Electronics-world9/Wallace-Tree-Multiplier-using-bypass-adder/images/stage1.png

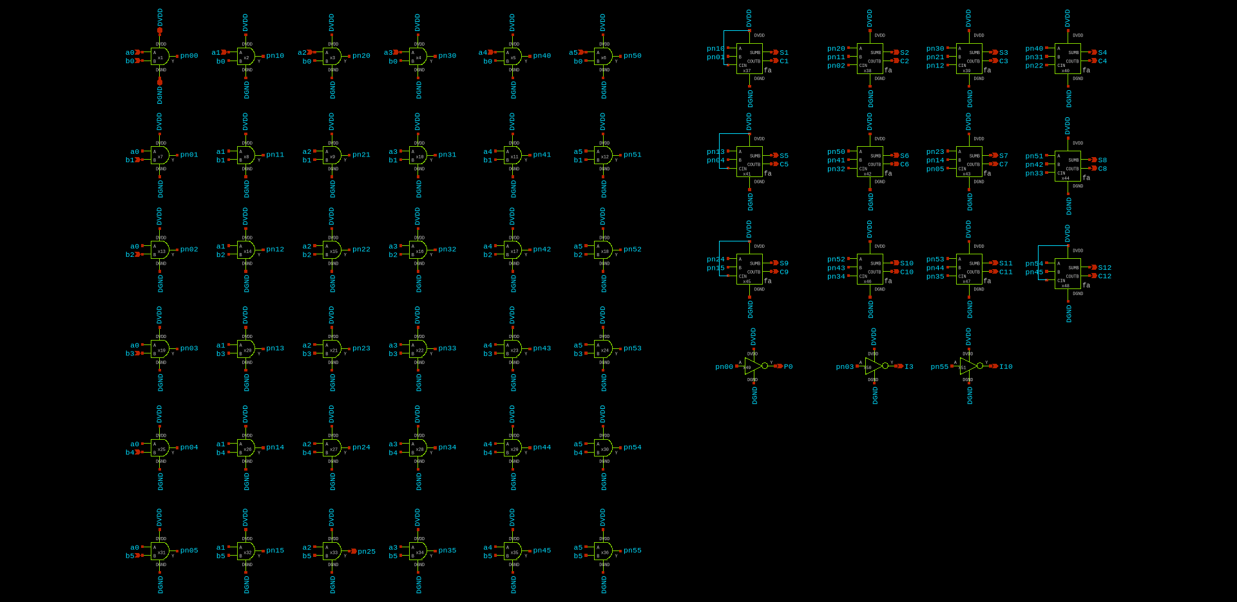
images/stage1.png
