Electronics-world9/Wallace-Tree-Multiplier-using-bypass-adder/images/stage2.png

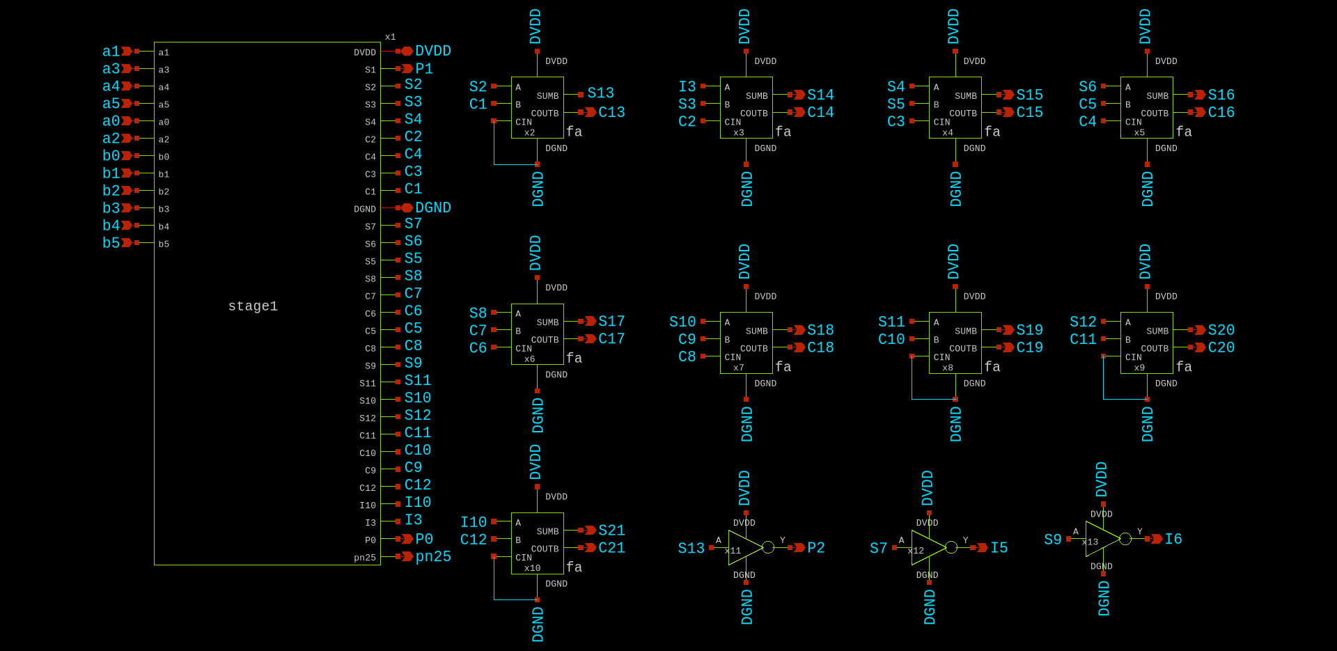
images/stage2.png
