Electronics-world9/Wallace-Tree-Multiplier-using-bypass-adder/images/stage3.png

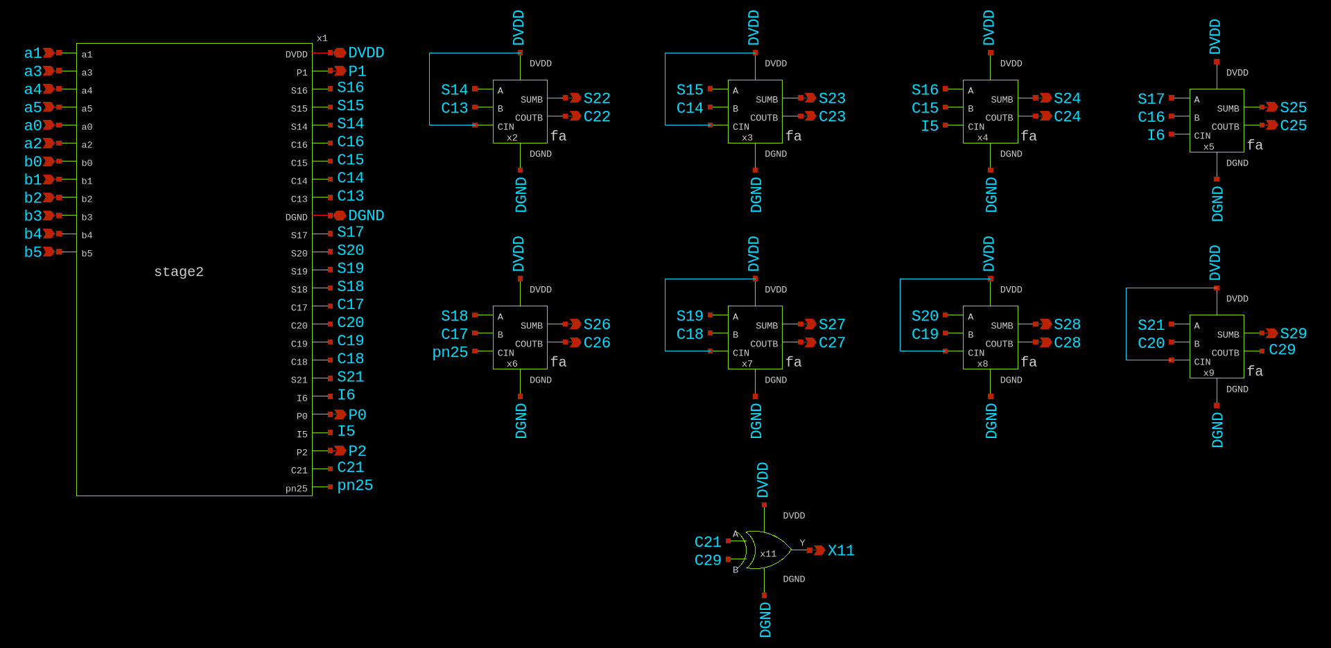
images/stage3.png
