Electronics-world9/Wallace-Tree-Multiplier-using-bypass-adder/images/post_layout_testbench.png

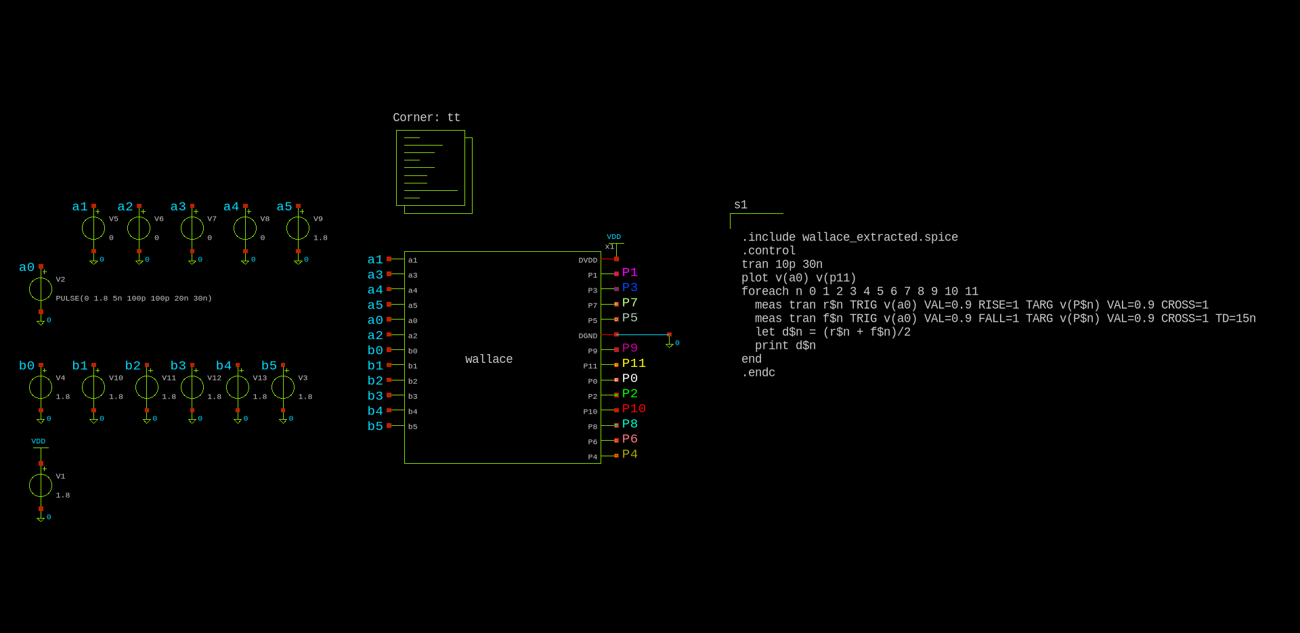
images/post_layout_testbench.png
