Electronics-world9/Wallace-Tree-Multiplier-using-bypass-adder/images/pre_layout_testbench.png

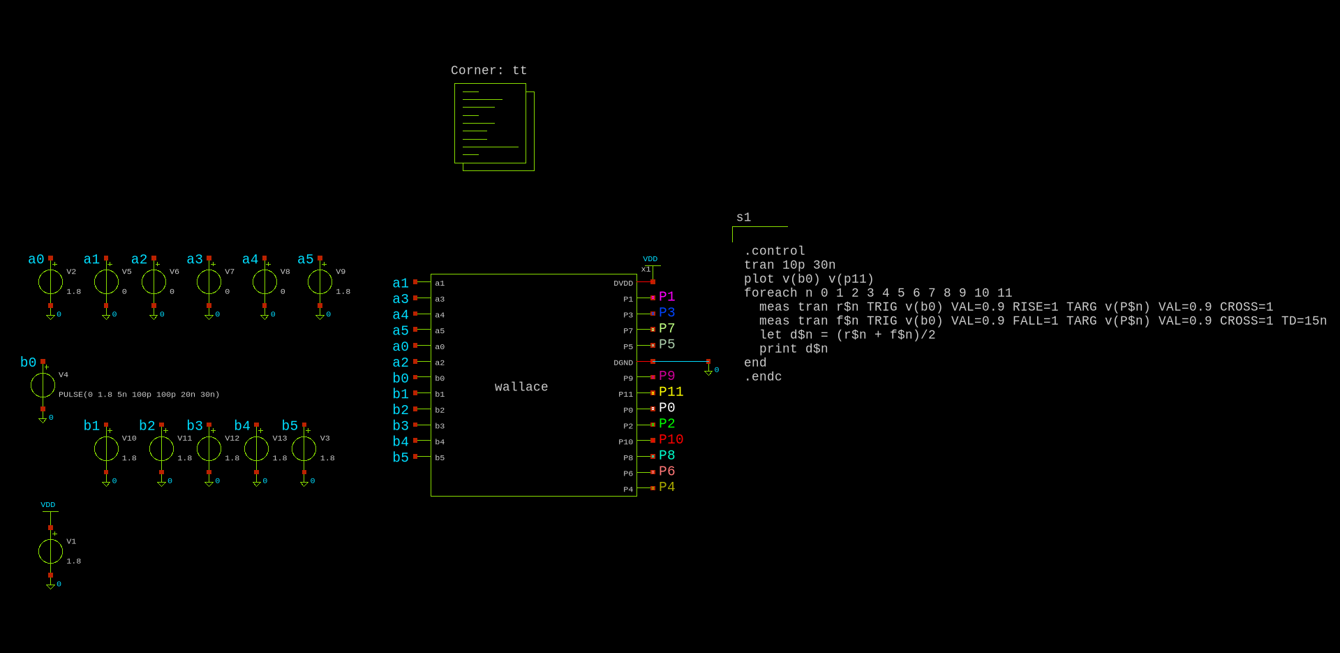
images/pre_layout_testbench.png
