Electronics-world9/Wallace-Tree-Multiplier-using-bypass-adder/images/results/drc_no_errors.png

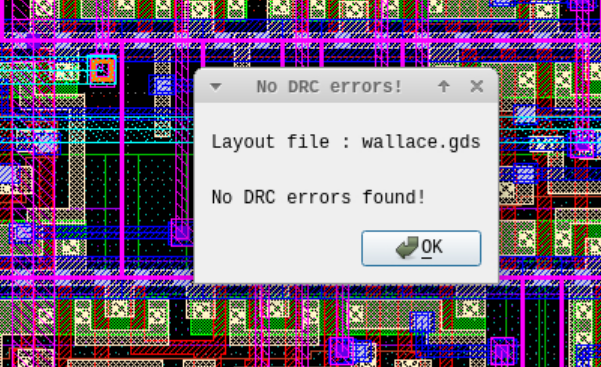
images/results/drc_no_errors.png
