Electronics-world9/Wallace-Tree-Multiplier-using-bypass-adder/images/results/lvs_match.png

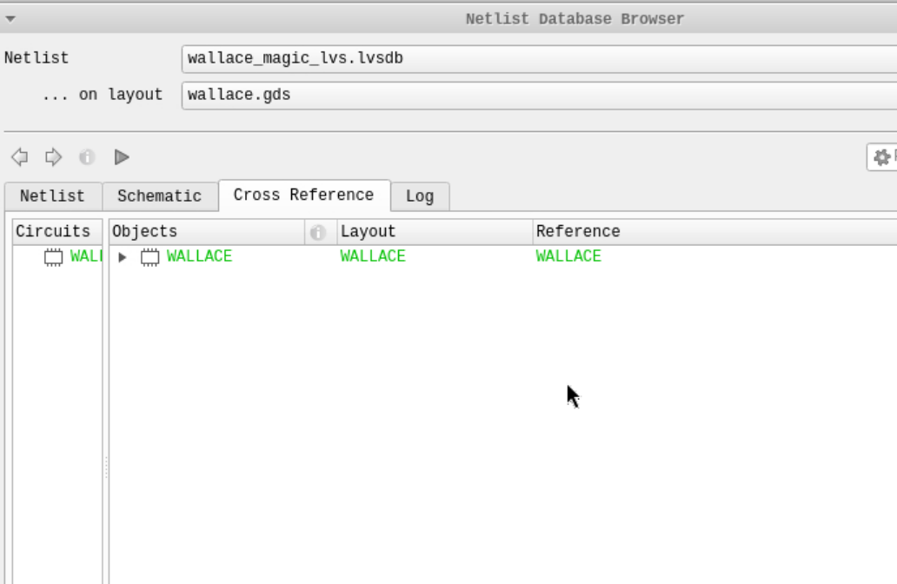
images/results/lvs_match.png
