Electronics-world9/Wallace-Tree-Multiplier-using-bypass-adder/images/results/post_layout_delay_vector3.png

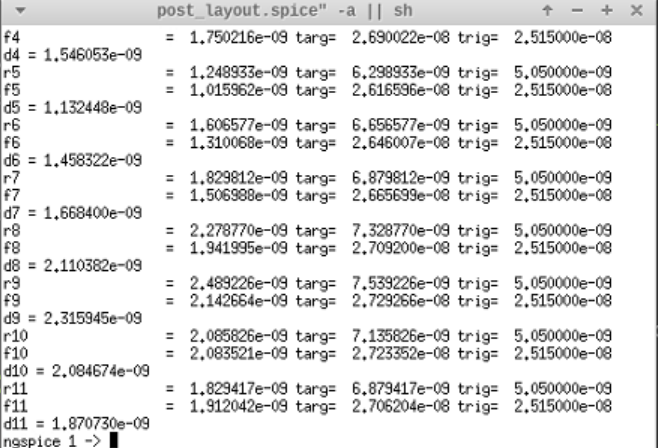
images/results/post_layout_delay_vector3.png
