Electronics-world9/Wallace-Tree-Multiplier-using-bypass-adder/images/results/post_layout_waveform.png

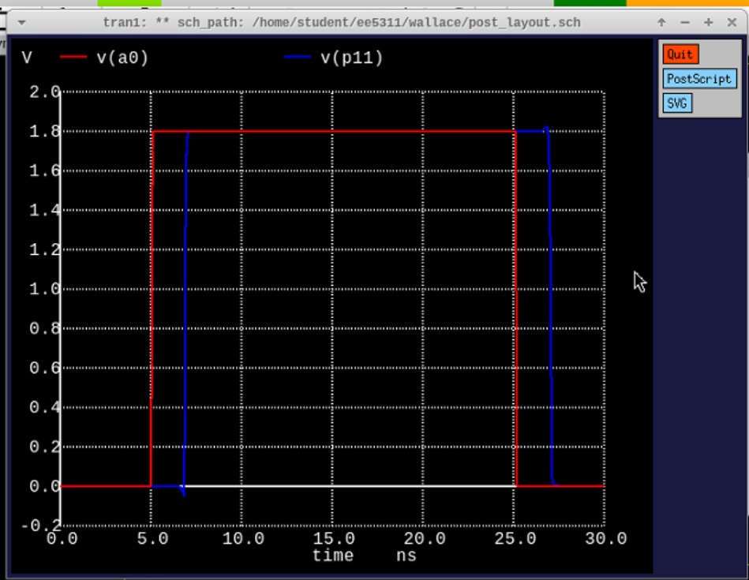
images/results/post_layout_waveform.png
