Electronics-world9/Wallace-Tree-Multiplier-using-bypass-adder/images/results/pre_layout_delay_vector2.png

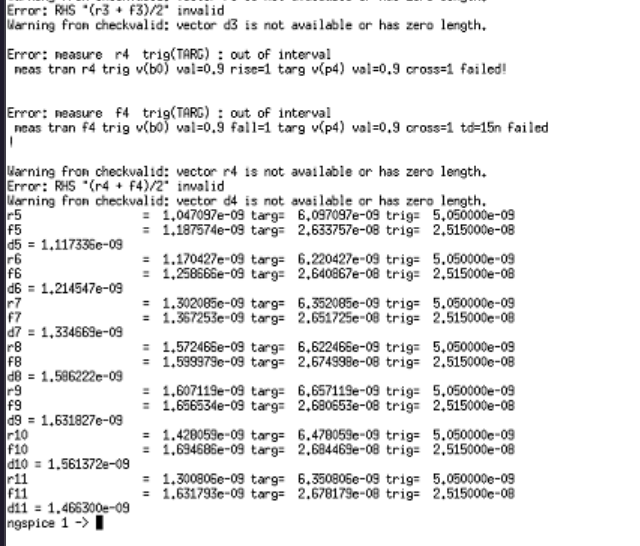
images/results/pre_layout_delay_vector2.png
