Electronics-world9/Wallace-Tree-Multiplier-using-bypass-adder/images/results/pre_layout_waveform.png

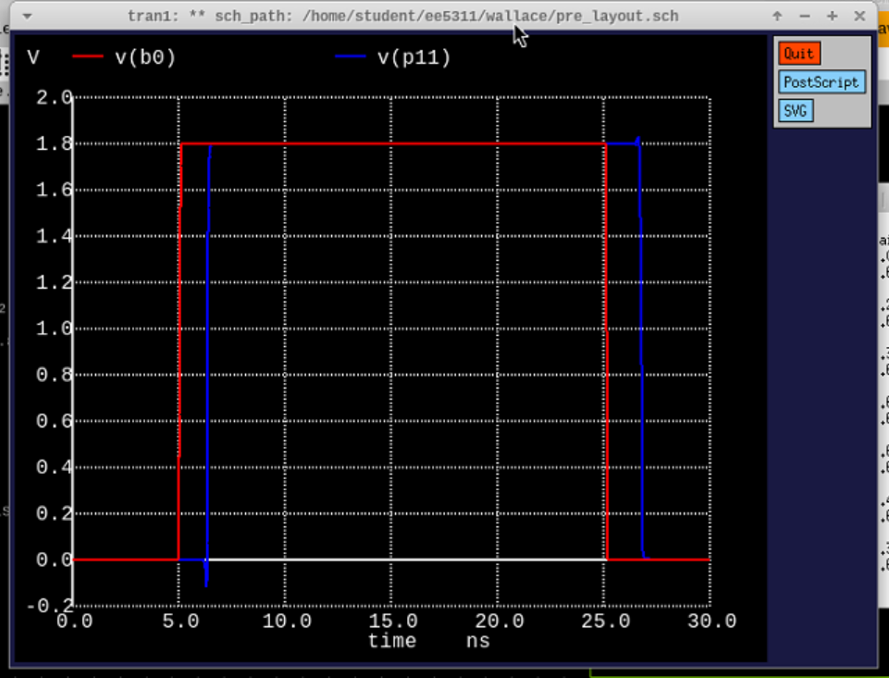
images/results/pre_layout_waveform.png
