Electronics-world9/Wallace-Tree-Multiplier-using-bypass-adder/xschem/fa.spice

** sch_path: /home/student/ee5311/Wallace/fa.sch
.subckt fa DVDD DGND A B CIN COUTB SUMB
*.PININFO COUTB:O CIN:I DVDD:B DGND:B SUMB:O B:I A:I
XM3 SUMB CIN net4 DGND sky130_fd_pr__nfet_01v8 L=0.15 W=0.42 nf=1
XM1 net2 A DVDD DVDD sky130_fd_pr__pfet_01v8 L=0.15 W=0.42 nf=1
XM2 net1 B net2 DVDD sky130_fd_pr__pfet_01v8 L=0.15 W=0.42 nf=1
XM4 SUMB CIN net1 DVDD sky130_fd_pr__pfet_01v8 L=0.15 W=0.42 nf=1
XM5 net4 B net3 DGND sky130_fd_pr__nfet_01v8 L=0.15 W=0.42 nf=1
XM6 net3 A DGND DGND sky130_fd_pr__nfet_01v8 L=0.15 W=0.42 nf=1
XM7 net5 A DVDD DVDD sky130_fd_pr__pfet_01v8 L=0.15 W=0.42 nf=1
XM8 net5 B DVDD DVDD sky130_fd_pr__pfet_01v8 L=0.15 W=0.42 nf=1
XM9 net5 CIN DVDD DVDD sky130_fd_pr__pfet_01v8 L=0.15 W=0.42 nf=1
XM10 SUMB COUTB net5 DVDD sky130_fd_pr__pfet_01v8 L=0.15 W=0.42 nf=1
XM11 net6 A DGND DGND sky130_fd_pr__nfet_01v8 L=0.15 W=0.42 nf=1
XM12 net6 B DGND DGND sky130_fd_pr__nfet_01v8 L=0.15 W=0.42 nf=1
XM13 net6 CIN DGND DGND sky130_fd_pr__nfet_01v8 L=0.15 W=0.42 nf=1
XM14 SUMB COUTB net6 DGND sky130_fd_pr__nfet_01v8 L=0.15 W=0.42 nf=1
XM15 COUTB CIN net10 DGND sky130_fd_pr__nfet_01v8 L=0.15 W=0.42 nf=1
XM16 net7 A DVDD DVDD sky130_fd_pr__pfet_01v8 L=0.15 W=0.42 nf=1
XM17 COUTB B net7 DVDD sky130_fd_pr__pfet_01v8 L=0.15 W=0.42 nf=1
XM18 COUTB CIN net9 DVDD sky130_fd_pr__pfet_01v8 L=0.15 W=0.42 nf=1
XM19 COUTB B net8 DGND sky130_fd_pr__nfet_01v8 L=0.15 W=0.42 nf=1
XM20 net8 A DGND DGND sky130_fd_pr__nfet_01v8 L=0.15 W=0.42 nf=1
XM21 net9 A DVDD DVDD sky130_fd_pr__pfet_01v8 L=0.15 W=0.42 nf=1
XM22 net9 B DVDD DVDD sky130_fd_pr__pfet_01v8 L=0.15 W=0.42 nf=1
XM23 net10 A DGND DGND sky130_fd_pr__nfet_01v8 L=0.15 W=0.42 nf=1
XM24 net10 B DGND DGND sky130_fd_pr__nfet_01v8 L=0.15 W=0.42 nf=1
.ends
